ScienceWorldCA/Exhibit-potatophone/BuildLogPictures/boxback.jpg

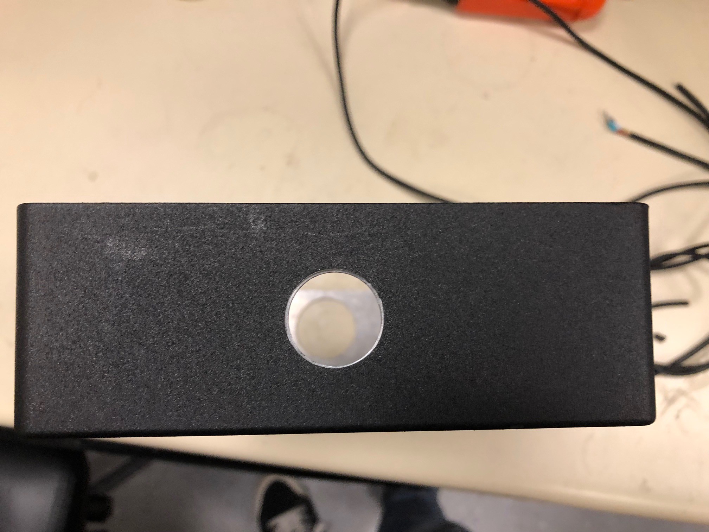
BuildLogPictures/boxback.jpg
