ScienceWorldCA/Exhibit-potatophone/BuildLogPictures/audioboard.jpg

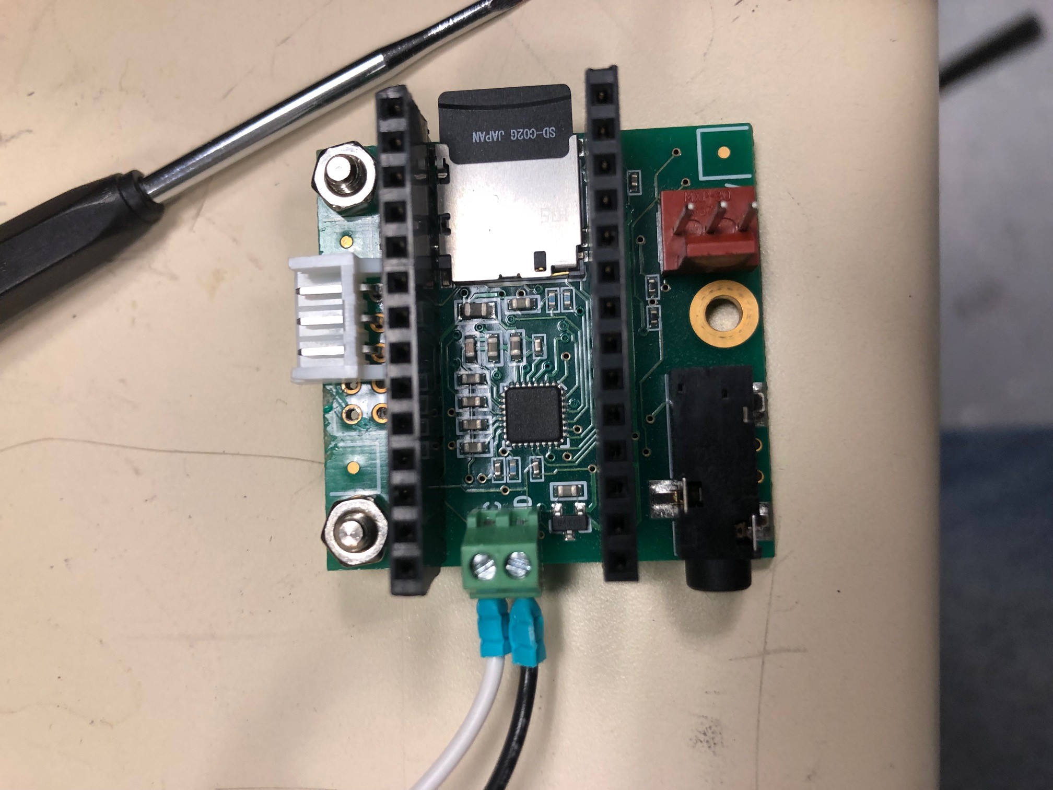
BuildLogPictures/audioboard.jpg
