ScienceWorldCA/Exhibit-potatophone/BuildLogPictures/backofwiring.jpg

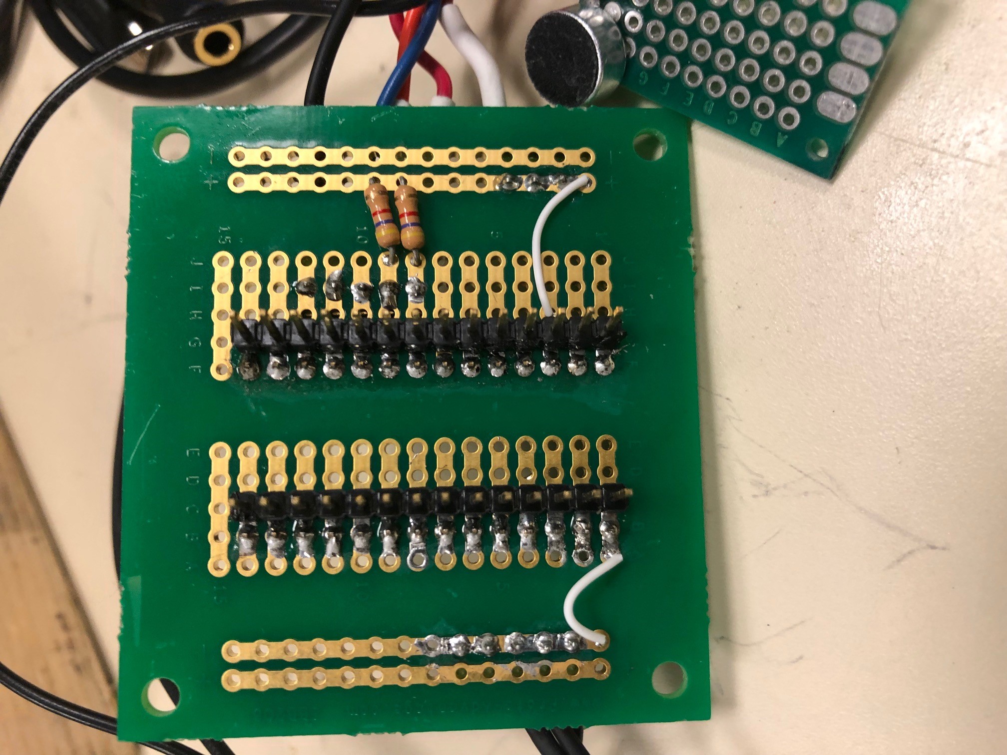
BuildLogPictures/backofwiring.jpg
