ScienceWorldCA/Exhibit-potatophone/BuildLogPictures/completewiring.jpg

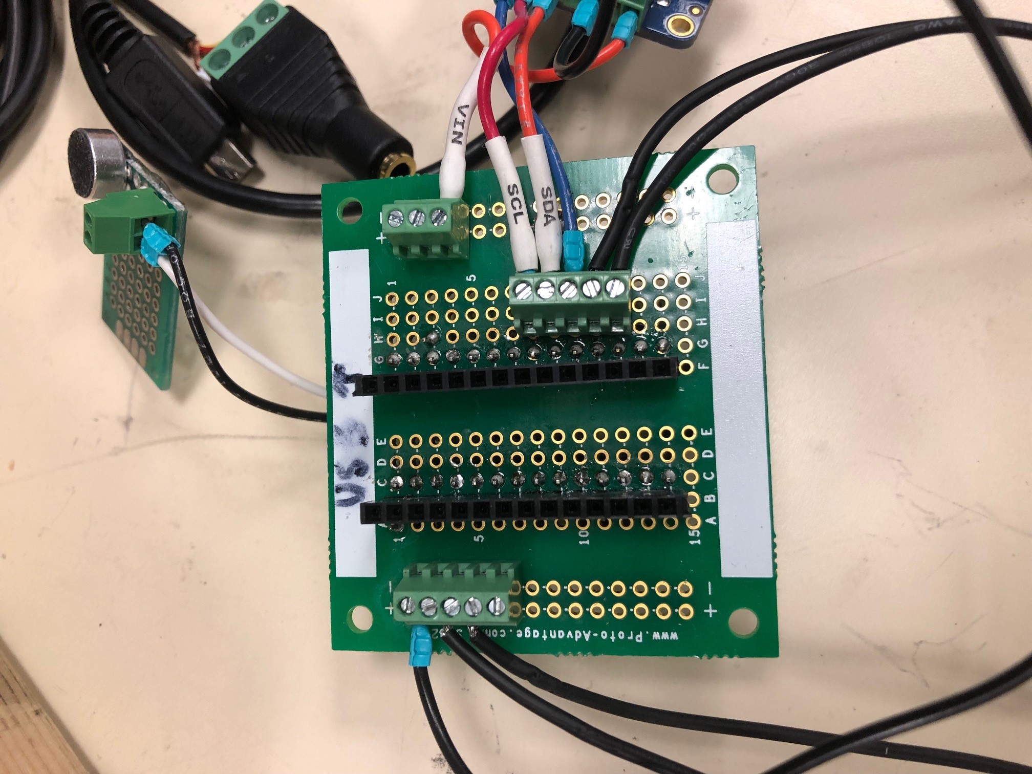
BuildLogPictures/completewiring.jpg
