ScienceWorldCA/Exhibit-potatophone/BuildLogPictures/mpr121wiring.jpg

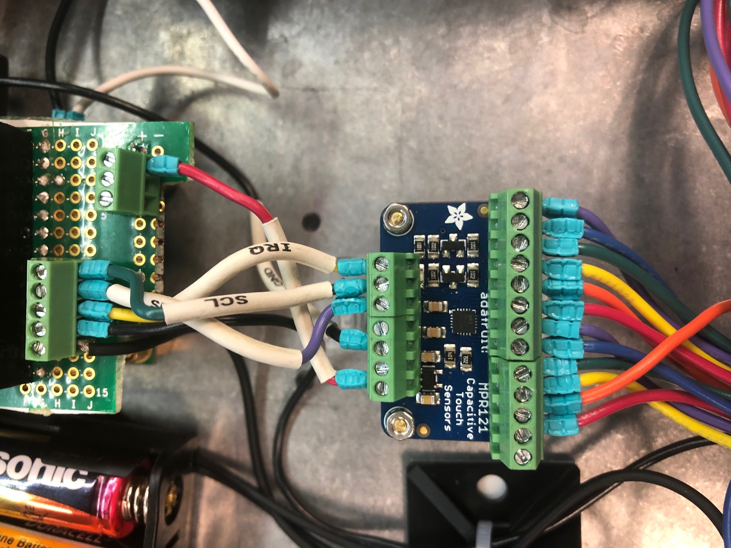
BuildLogPictures/mpr121wiring.jpg
