ScienceWorldCA/Exhibit-potatophone/BuildLogPictures/solderbridge.jpg

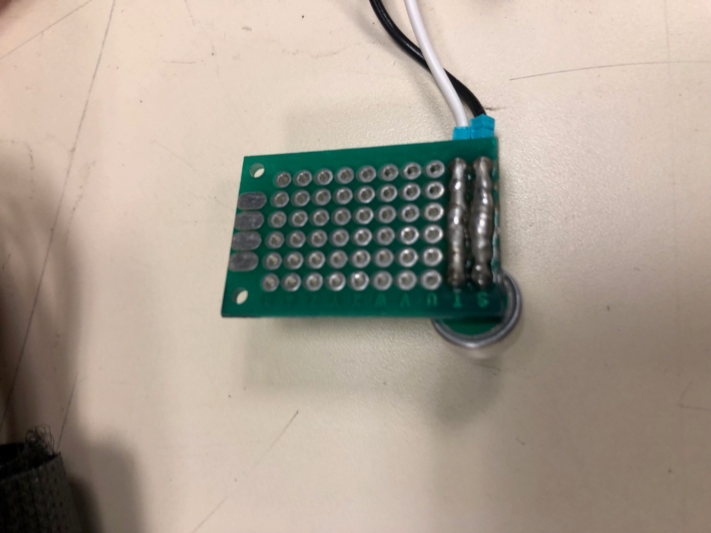
BuildLogPictures/solderbridge.jpg
