ScienceWorldCA/Exhibit-potatophone/BuildLogPictures/wiringwithteensy.jpg

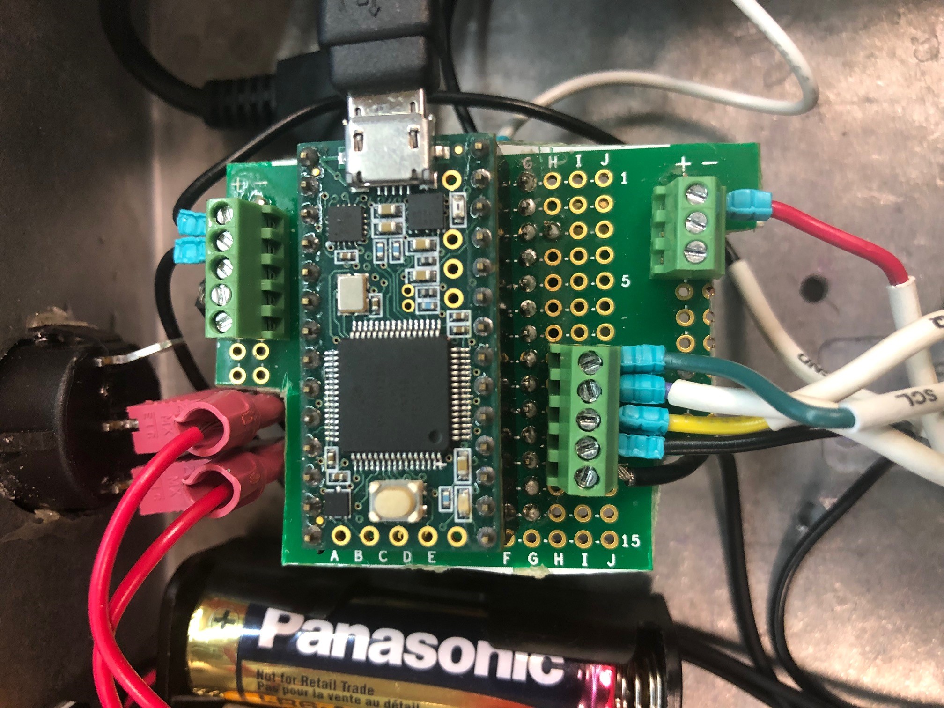
BuildLogPictures/wiringwithteensy.jpg
