ScienceWorldCA/Exhibit-potatophone/BuildLogPictures/boxaudio.jpg

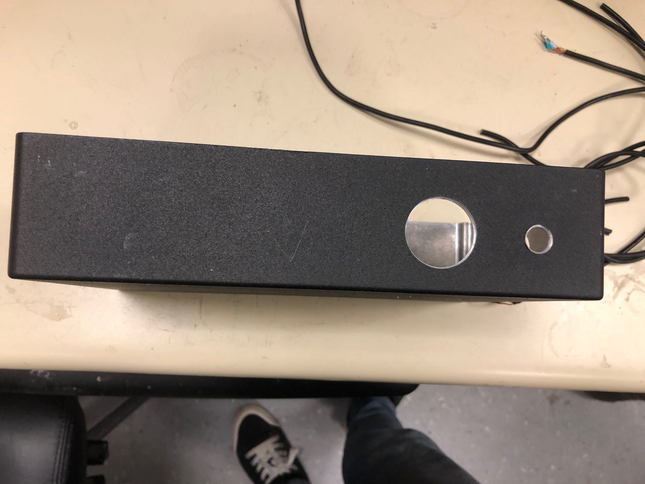
BuildLogPictures/boxaudio.jpg
