ScienceWorldCA/Exhibit-potatophone/BuildLogPictures/boxbutton.jpg

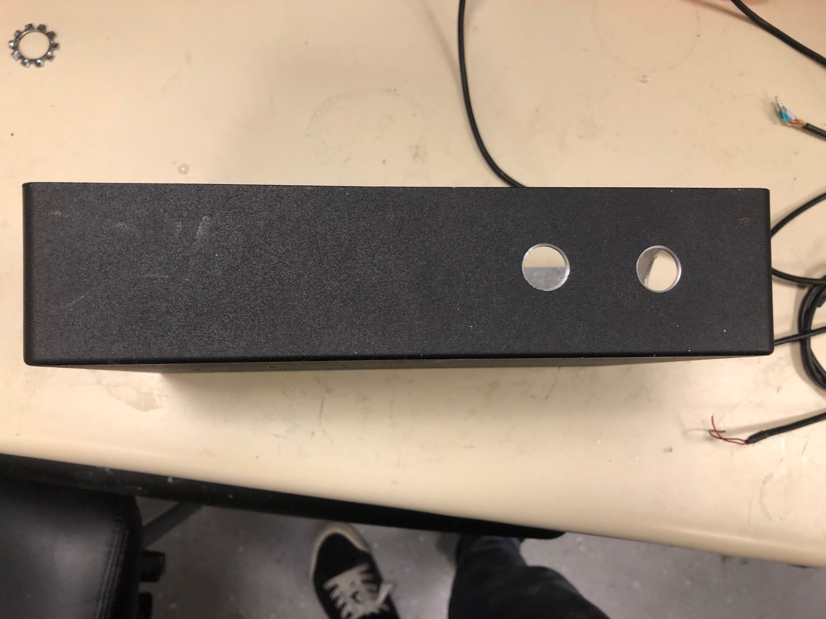
BuildLogPictures/boxbutton.jpg
