ScienceWorldCA/Exhibit-potatophone/BuildLogPictures/boxfront.jpg

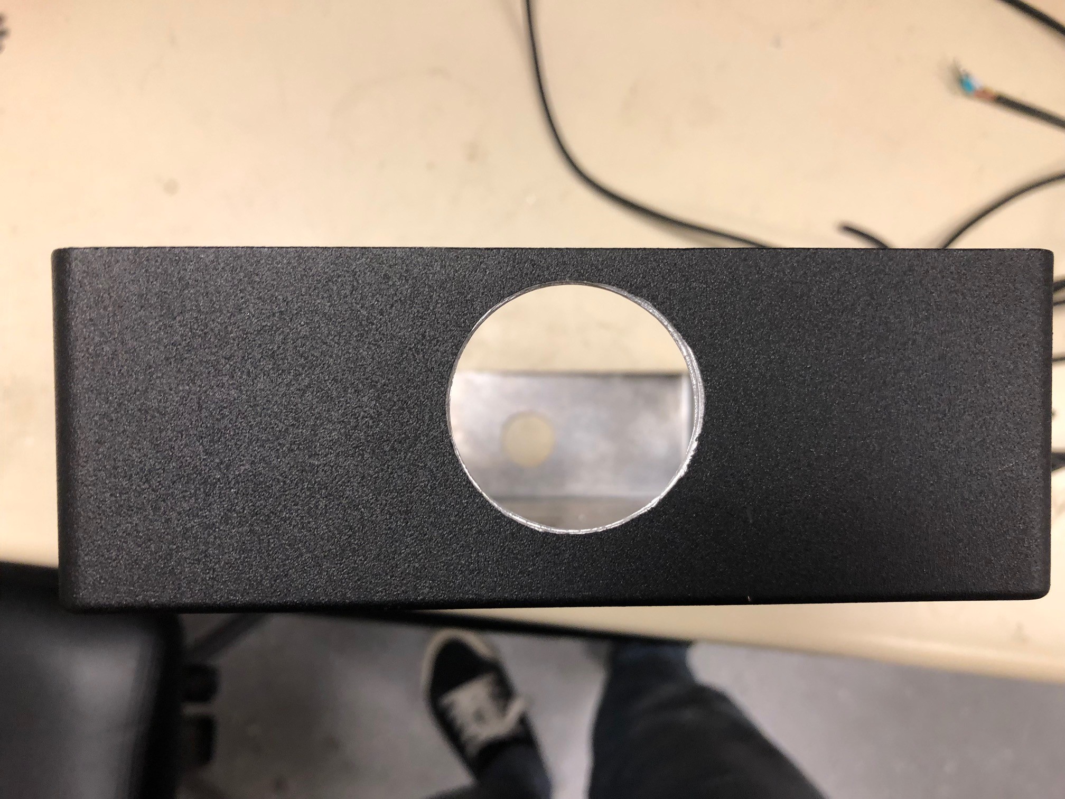
BuildLogPictures/boxfront.jpg
