ScienceWorldCA/Exhibit-potatophone/(commit log)

2019-08-01 Fixed chords + added voice input keyboard
    TODO: update comments and create libraries
    [main.ino]
2019-08-18 Fixed Audio Files to correct format
    [main.ino]
